benilton02/termometro_digital/README.md

##  Digital Thermometer

> Develop a prototype of a Digital Thermometer using Arduino and its accessories. According to the necessary requirements.

##  Requirements

> 1. It Must contain a temperature sensor **(DHT-11)**;
>
> 2. It must contain a **LCD Display**, or similar, to indicate the temperature with two floating point, showing maximum and minimum Temperature on display;
>
> 3. It activate a siren out of the working range **(MIN = 25,2°C e MAX = 32,6°C)**;
>
> 4. It should be easy to move and install, i.e., small, lightweight, portable and DC-powered;
>
> 5. It must have a structure made of plastic, wood, or any other kind of material;
>
>
  
  ## 5W2H
| What | Why | Where | Who | When | How | How Many|
|--|--|--|--|--|--|--|
|  To Search for similar works | To take as a starting point | Internet and Youtube | Amanda | 9/may| Searches were made in the datasheets and in several websites about previous projects that used the DTH11 sensor and similar devices | Free |
|  Bibliographic study of the components| For application in the project | Internet | Amanda | 10/may | The studying of the datasheets of each component and device used in the design of the system | Free |
| Electrical scheme design| Electrical circuit building | Proteus | Ingrid| 15/may | To check datasheet of Arduino Uno, LCD Display, DHT11 and buzzer for schematic design | Free |
|  Electrical scheme Review| To Check for faults in the electrical scheme  | Proteus | Emerson|16/may | Verification of the components to be used and their position in the schematic | Free |
|  Search project components | Calculate costs, check suitability for the project | Google meet | Emerson | 11/may | Meeting with the team to dimension the components  | Free |
|  Components purchase| Assembling and building of project |  Mercado Livre |Emerson| 12~16/may | Bank payment | 73,90 BRL |
|  Auxiliary circuit assembling| Assembling and building of project |  LSE | Ingrid | 17/may | Mounting of components on the PCB | Free |
|  Auxiliary circuit assembling review| Check assembling according to the scheme | LSE | Emerson | 18/may| To test electrical connections | Free |
|  3D modeling | Protection of the Arduino and auxiliary circuit | Inventor | Ingrid | 19/may | Project made in CAD with the dimensions of circuit and display to be grouped | Free |
|  Printing 3d Model| Protection of the Arduino and auxiliary circuit | 3D printer | Ingrid | 20/may | It was placed to print on the material in gray PLA (Cura) | Free |
|  3d printing Assembling | Protection of the Arduino and auxiliary circuit | LSE | Ingrid | 20/may | Screwing and fitting of the circuit mounted on the case | Free |
|  Versioning of project files| To preserve history of changes in project code and modeling files | Github | Benilton| 11~19/may|Git|Free|
|  Embed code | To embed code on Arduino | Arduino | Benilton | 16/may | IDE Arduino | Free|
|  Functional tests| To ensure the functioning of the prototype | Prototype | Benilton | 11~19/may | Test scenarios |Free|
|  Technical report| To show all the phases carried out in the project | Word | Amanda | 22/may | To document all phases of the project, from an initial bibliographic search to the final functional test | Free |

##  Schematic

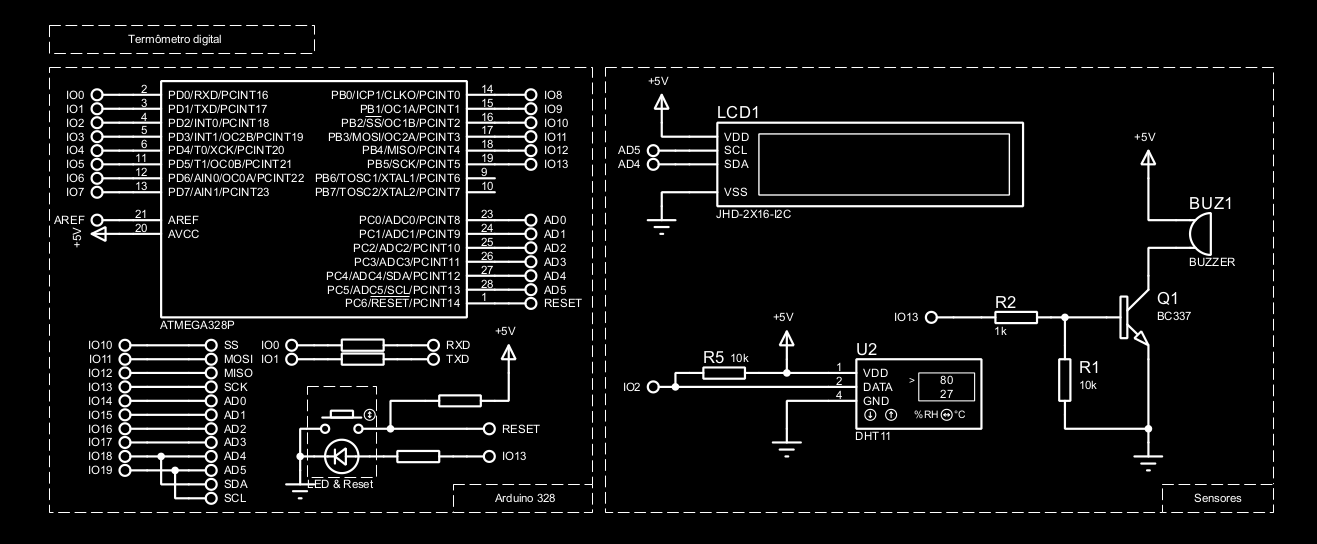
[picture p1: assets/schematic.png]
Esquema Elétrico


## Printing - 3D Model

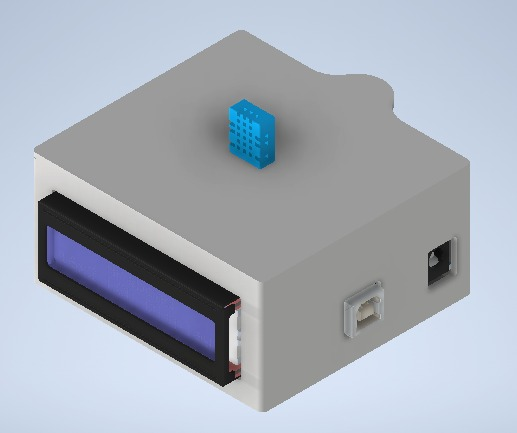
[picture p2: assets/close_prototype.jpeg]
close_prototype


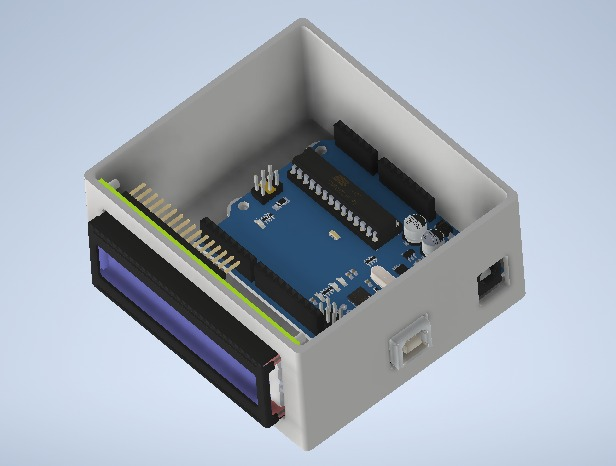
[picture p3: assets/open_prototype.jpeg]
open_prototype


##  Plus - Kicad (3D Model) 

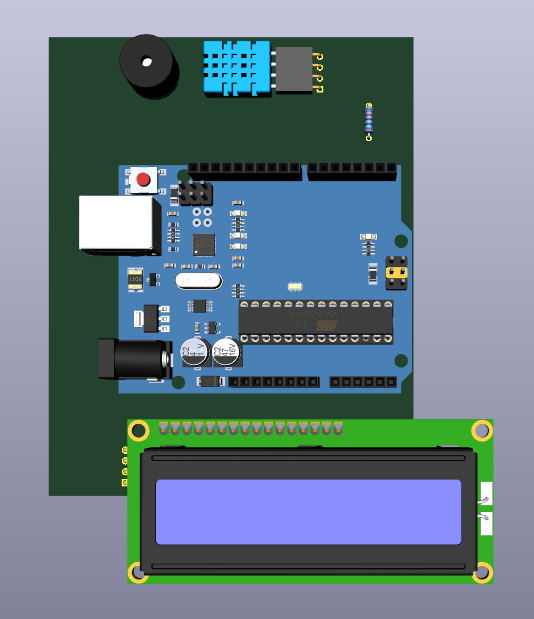
[picture p4: assets/top_model.png]
top_model


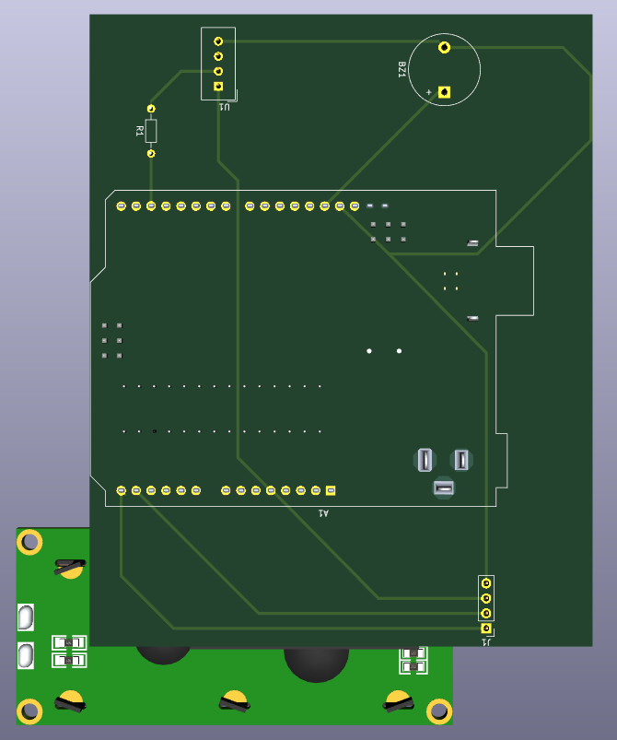
[picture p5: assets/bottom_model.png]
bottom_model


## Real Prototype

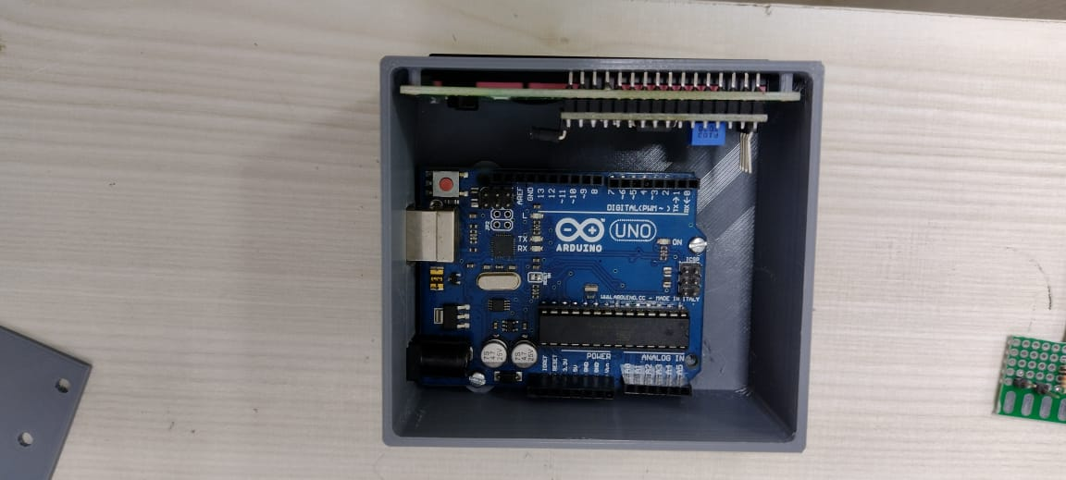
[picture p6: assets/assembling_1.jpeg]
assembling_1

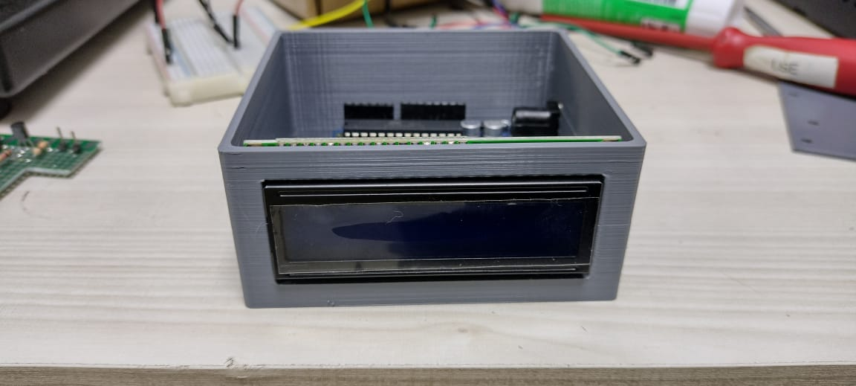
[picture p7: assets/assembling_2.jpeg]
assembling_2

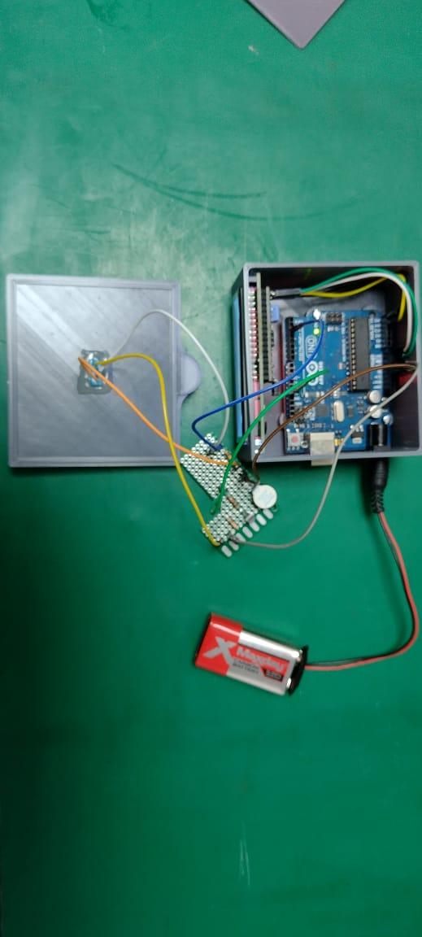
[picture p8: assets/assembling_3.jpeg]
assembling_3

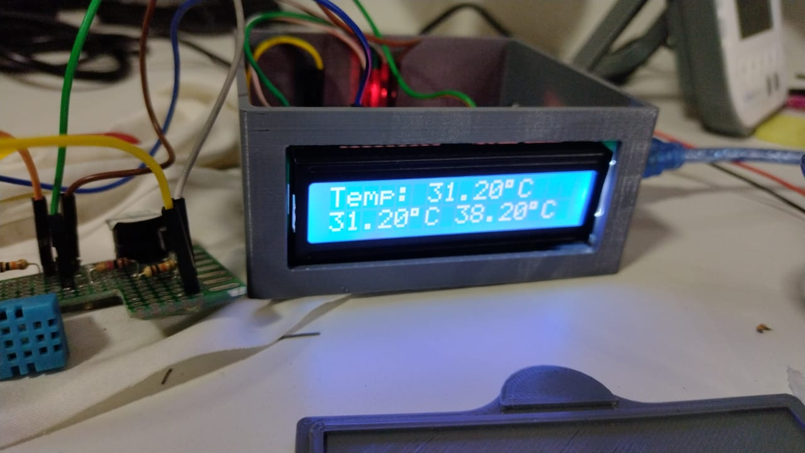
[picture p9: assets/assembling_4.jpeg]
assembling_4

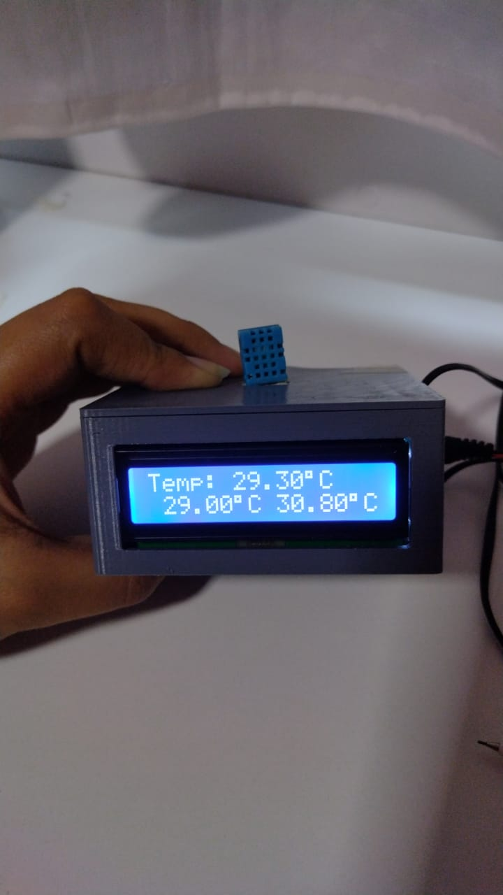
[picture p10: assets/final_assembling.jpeg]
final_assembling


## Team

> Amanda da Silva Barbosa
>
> Benilton Seixas Andrade 
>
> Emerson da Silva Muniz
>
> Ingrid Mayumi Fonseca Ono
