benilton02/termometro_digital/(commit log)

2021-05-12 feat: get min and max temperature
2021-05-12 refact: add group of threads
2021-05-16 feat: integration with the I2C display
2021-05-17 feat: add kicad project
2021-05-19 :books: docs: 3d printing files
2021-06-03 :bug: bugfix: add cf
    [app.ino]
2021-06-03 :bug: bugfix: format output on display
    [app.ino]
